GabrielKeys/Projeto_Alarme_FPGA/vivado_fpga/Projeto_Alarme_FPGA/Projeto_Alarme_FPGA.runs/impl_1/.init_design.begin.rst

<?xml version="1.0"?>
<ProcessHandle Version="1" Minor="0">
    <Process Command=".planAhead." Owner="Gabriel" Host="DESKTOP-I9EHUIA" Pid="15572">
    </Process>
</ProcessHandle>
