GabrielKeys/Projeto_Alarme_FPGA/vivado_fpga/Projeto_Alarme_FPGA/Projeto_Alarme_FPGA.runs/impl_1/.vivado.begin.rst

<?xml version="1.0"?>
<ProcessHandle Version="1" Minor="0">
    <Process Command="vivado.bat" Owner="Gabriel" Host="DESKTOP-I9EHUIA" Pid="11236">
    </Process>
</ProcessHandle>
