GabrielKeys/Projeto_Alarme_FPGA/imagens/dashboard_mqtt_inicial.png

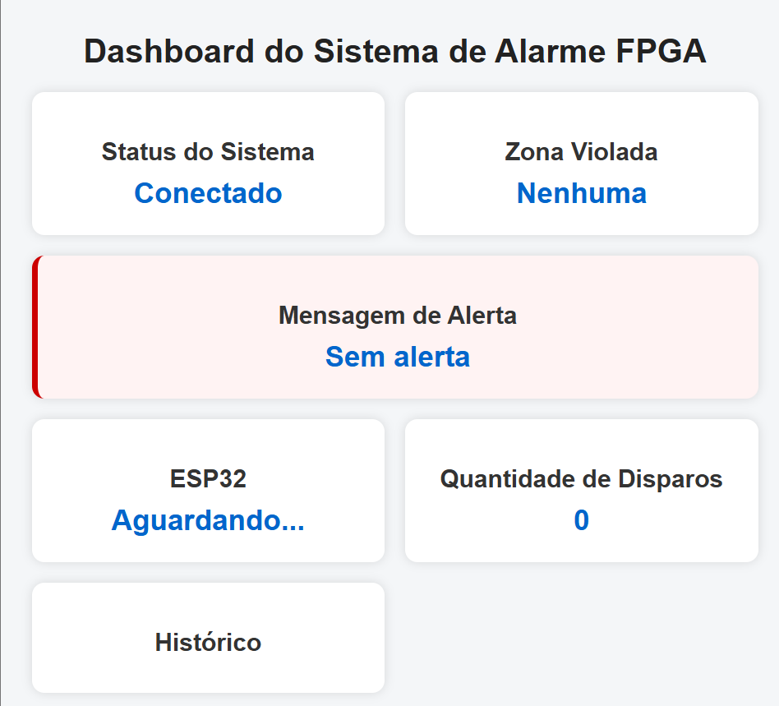
imagens/dashboard_mqtt_inicial.png
