GabrielKeys/Projeto_Alarme_FPGA/imagens/dashboard_mqtt_melhorado.png

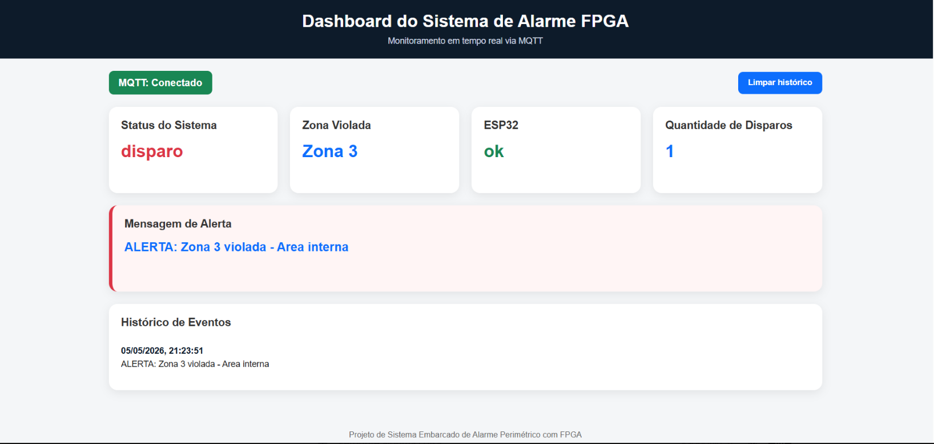
imagens/dashboard_mqtt_melhorado.png
