GabrielKeys/Projeto_Alarme_FPGA/imagens/implementacao_vivado.png

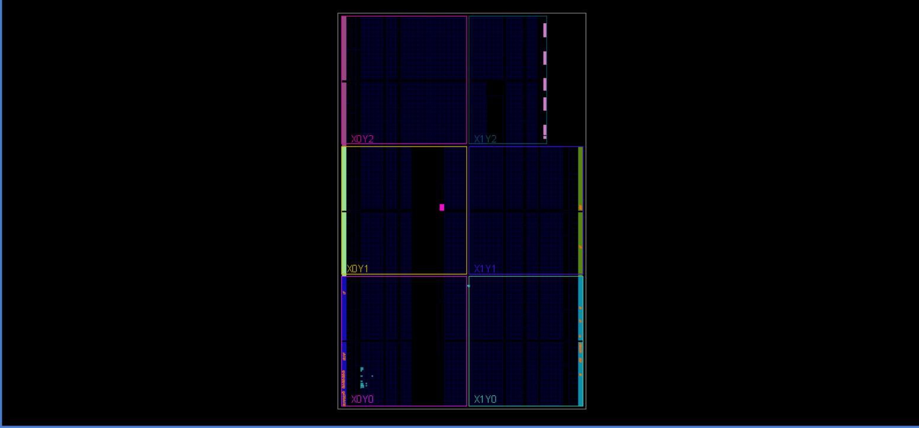
imagens/implementacao_vivado.png
