GabrielKeys/Projeto_Alarme_FPGA/imagens/simulacao_esp_zonas.png

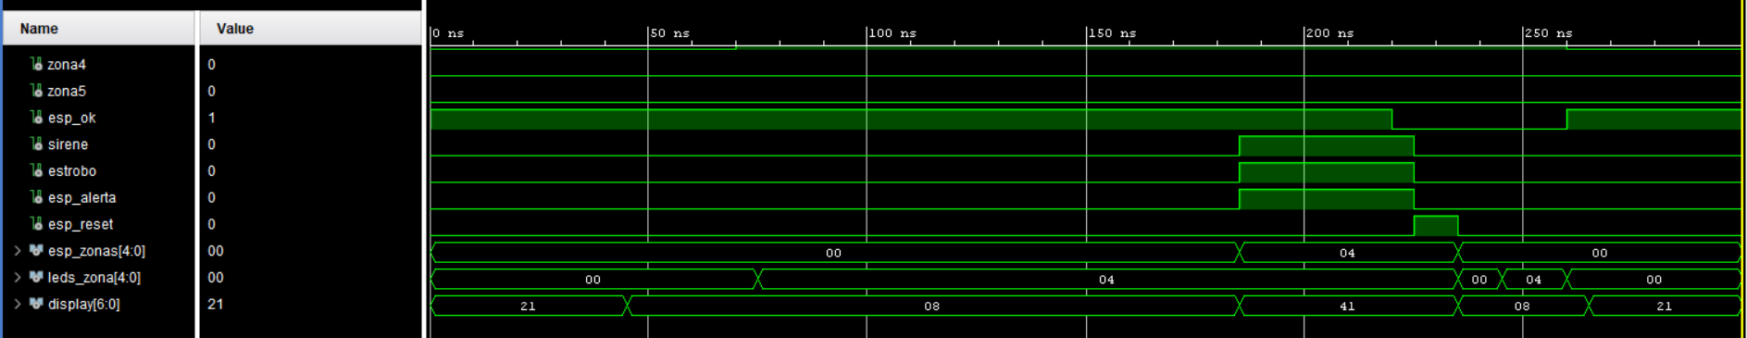
imagens/simulacao_esp_zonas.png
