GabrielKeys/Projeto_Alarme_FPGA/imagens/simulacao_mef_vivado.png

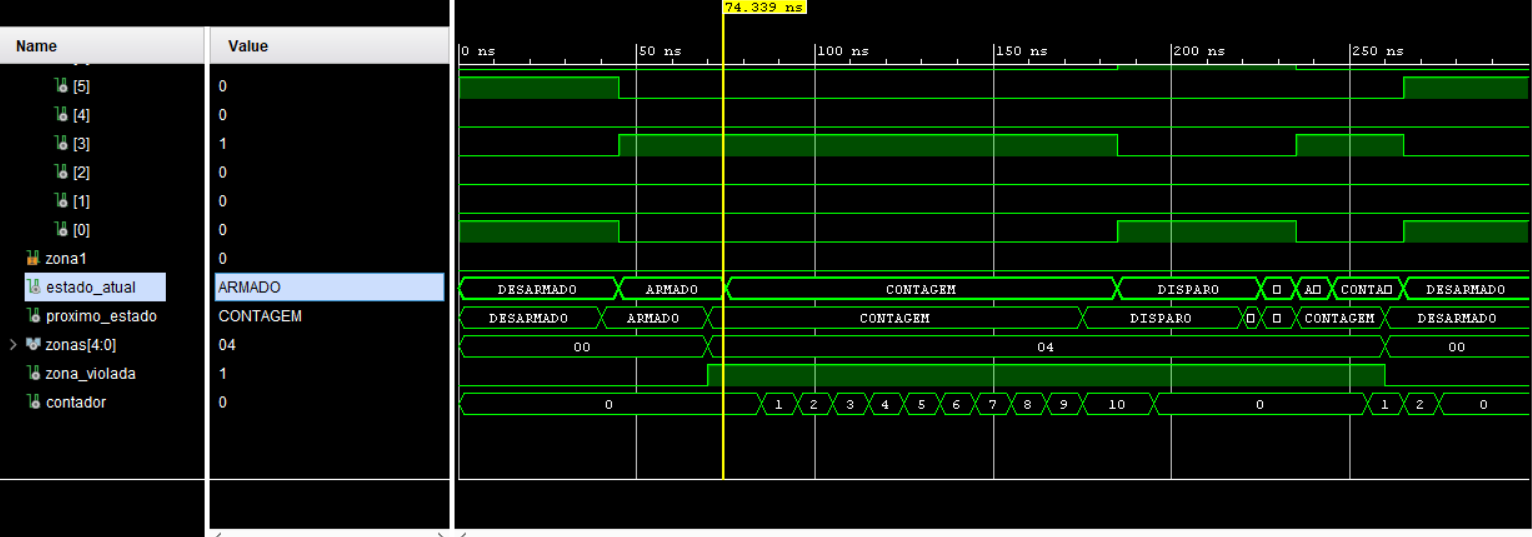
imagens/simulacao_mef_vivado.png
