GabrielKeys/Projeto_Alarme_FPGA/imagens/simulacao_zona_memorizada.png

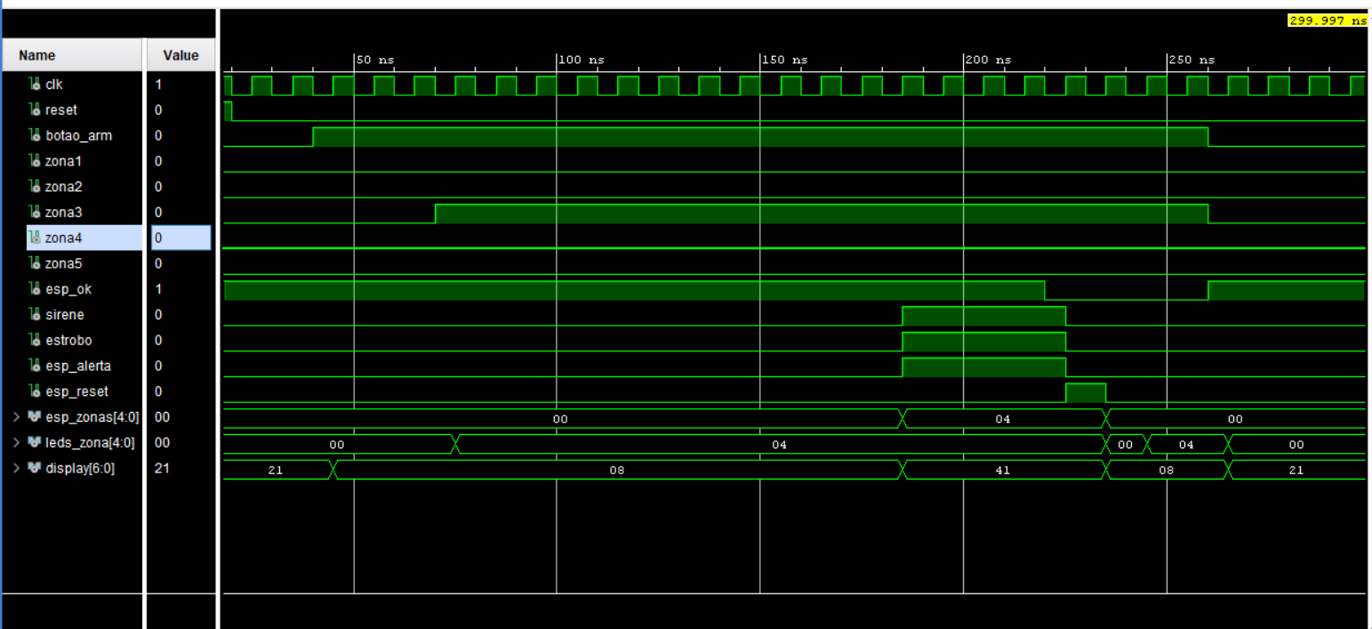
imagens/simulacao_zona_memorizada.png
