GabrielKeys/Projeto_Alarme_FPGA/vivado_fpga/Projeto_Alarme_FPGA/Projeto_Alarme_FPGA.runs/impl_1/usage_statistics_webtalk.html

### Device Usage Page (usage_statistics_webtalk.html)

This HTML page displays the device usage statistics that will be sent to Xilinx.
To see the actual file transmitted to Xilinx, please click here.

software_version_and_target_device
beta | FALSE | build_version | 2258646
date_generated | Mon Jun 15 19:28:20 2026 | os_platform | WIN64
product_version | Vivado v2018.2 (64-bit) | project_id | 2028425938d547d3b7b5718255f06e1f
project_iteration | 11 | random_id | 14f6a7cc-3bba-4563-a50c-01388174601d
registration_id | 14f6a7cc-3bba-4563-a50c-01388174601d | route_design | TRUE
target_device | xc7a35t | target_family | artix7
target_package | cpg236 | target_speed | -1
tool_flow | Vivado

user_environment
cpu_name | Intel(R) Core(TM) i5-9300H CPU @ 2.40GHz | cpu_speed | 2400 MHz
os_name | Microsoft Windows 8 or later , 64-bit | os_release | major release (build 9200)
system_ram | 8.000 GB | total_processors | 1

vivado_usage

gui_handlers
abstractfileview_reload=1 | addsrcwizard_specify_or_create_constraint_files=2 | addsrcwizard_specify_simulation_specific_hdl_files=1 | basedialog_cancel=5
basedialog_ok=28 | basedialog_yes=5 | closeplanner_yes=3 | cmdmsgdialog_ok=9
commandsinput_type_tcl_command_here=7 | constraintschooserpanel_add_files=1 | filesetpanel_file_set_panel_tree=32 | filtertoolbar_show_all=1
flownavigatortreepanel_flow_navigator_tree=65 | fpgachooser_family=1 | fpgachooser_fpga_table=1 | fpgachooser_package=1
fpgachooser_speed=1 | gettingstartedview_create_new_project=1 | graphicalview_zoom_fit=6 | hardwaretreepanel_hardware_tree_table=9
hcodeeditor_search_text_combo_box=2 | launchpanel_generate_scripts_only=1 | logmonitor_monitor=1 | mainmenumgr_file=2
mainmenumgr_run=2 | mainmenumgr_tools=2 | mainmenumgr_view=8 | mainwinmenumgr_layout=20
msgtreepanel_message_view_tree=3 | newprojectwizard_do_not_specify_sources_at_this_time=1 | numjobschooser_number_of_jobs=2 | pacommandnames_auto_connect_target=13
pacommandnames_goto_netlist_design=2 | pacommandnames_reports_window=2 | pacommandnames_run_bitgen=1 | pacommandnames_simulation_run_behavioral=7
paviews_device=1 | paviews_flow_navigator=1 | programdebugtab_available_targets_on_server=1 | programdebugtab_open_target=15
programdebugtab_program_device=8 | programdebugtab_refresh_device=12 | programfpgadialog_program=24 | progressdialog_cancel=2
projectnamechooser_choose_project_location=2 | projectnamechooser_project_name=1 | rdicommands_reset_layout=7 | rdiviews_waveform_viewer=53
simulationobjectspanel_simulation_objects_tree_table=7 | simulationscopespanel_simulate_scope_table=21 | srcchooserpanel_add_hdl_and_netlist_files_to_your_project=2 | tclconsoleview_copy=2
tclconsoleview_tcl_console_code_editor=9 | waveformnametree_waveform_name_tree=4

java_command_handlers
addsources=4 | autoconnecttarget=13 | launchprogramfpga=27 | newhardwaredashboard=1
newproject=1 | openhardwaremanager=24 | openrecenttarget=1 | programdevice=22
refreshdevice=11 | resetlayout=7 | runbitgen=12 | runimplementation=3
runsynthesis=4 | showview=2 | simulationrun=7 | toolssettings=1
viewtaskimplementation=3 | viewtaskprojectmanager=1 | viewtasksynthesis=2

other_data

guimode=12

project_data
constraintsetcount=1 | core_container=false | currentimplrun=impl_1 | currentsynthesisrun=synth_1
default_library=xil_defaultlib | designmode=RTL | export_simulation_activehdl=0 | export_simulation_ies=0
export_simulation_modelsim=0 | export_simulation_questa=0 | export_simulation_riviera=0 | export_simulation_vcs=0
export_simulation_xsim=0 | implstrategy=Vivado Implementation Defaults | launch_simulation_activehdl=0 | launch_simulation_ies=0
launch_simulation_modelsim=0 | launch_simulation_questa=0 | launch_simulation_riviera=0 | launch_simulation_vcs=0
launch_simulation_xsim=5 | simulator_language=Mixed | srcsetcount=1 | synthesisstrategy=Vivado Synthesis Defaults
target_language=Verilog | target_simulator=XSim | totalimplruns=1 | totalsynthesisruns=1

unisim_transformation

post_unisim_transformation
bufg=1 | carry4=7 | fdce=38 | gnd=1
ibuf=9 | lut2=12 | lut3=3 | lut4=14
lut5=4 | lut6=37 | obuf=21 | vcc=1

pre_unisim_transformation
bufg=1 | carry4=7 | fdce=38 | gnd=1
ibuf=9 | lut2=12 | lut3=3 | lut4=14
lut5=4 | lut6=37 | obuf=21 | vcc=1

report_drc

command_line_options
-append=default::[not_specified] | -checks=default::[not_specified] | -fail_on=default::[not_specified] | -force=default::[not_specified]
-format=default::[not_specified] | -internal=default::[not_specified] | -internal_only=default::[not_specified] | -messages=default::[not_specified]
-name=default::[not_specified] | -no_waivers=default::[not_specified] | -return_string=default::[not_specified] | -ruledecks=default::[not_specified]
-upgrade_cw=default::[not_specified] | -waived=default::[not_specified]

report_methodology

command_line_options
-append=default::[not_specified] | -checks=default::[not_specified] | -fail_on=default::[not_specified] | -force=default::[not_specified]
-format=default::[not_specified] | -messages=default::[not_specified] | -name=default::[not_specified] | -return_string=default::[not_specified]

-waived=default::[not_specified]

results

timing-18=29

report_power

command_line_options
-advisory=default::[not_specified] | -append=default::[not_specified] | -file=[specified] | -format=default::text
-hier=default::power | -l=default::[not_specified] | -name=default::[not_specified] | -no_propagation=default::[not_specified]
-return_string=default::[not_specified] | -rpx=[specified] | -verbose=default::[not_specified] | -vid=default::[not_specified]

-xpe=default::[not_specified]

usage
airflow=250 (LFM) | ambient_temp=25.0 (C) | bi-dir_toggle=12.500000 | bidir_output_enable=1.000000
board_layers=12to15 (12 to 15 Layers) | board_selection=medium (10"x10") | clocks=0.001000 | confidence_level_clock_activity=High
confidence_level_design_state=High | confidence_level_device_models=High | confidence_level_internal_activity=Medium | confidence_level_io_activity=Low
confidence_level_overall=Low | customer=TBD | customer_class=TBD | devstatic=0.071719
die=xc7a35tcpg236-1 | dsp_output_toggle=12.500000 | dynamic=0.008717 | effective_thetaja=5.0
enable_probability=0.990000 | family=artix7 | ff_toggle=12.500000 | flow_state=routed
heatsink=medium (Medium Profile) | i/o=0.007328 | input_toggle=12.500000 | junction_temp=25.4 (C)
logic=0.000143 | mgtavcc_dynamic_current=0.000000 | mgtavcc_static_current=0.000000 | mgtavcc_total_current=0.000000
mgtavcc_voltage=1.000000 | mgtavtt_dynamic_current=0.000000 | mgtavtt_static_current=0.000000 | mgtavtt_total_current=0.000000
mgtavtt_voltage=1.200000 | netlist_net_matched=NA | off-chip_power=0.000000 | on-chip_power=0.080436
output_enable=1.000000 | output_load=5.000000 | output_toggle=12.500000 | package=cpg236
pct_clock_constrained=1.000000 | pct_inputs_defined=11 | platform=nt64 | process=typical
ram_enable=50.000000 | ram_write=50.000000 | read_saif=False | set/reset_probability=0.000000
signal_rate=False | signals=0.000245 | simulation_file=None | speedgrade=-1
static_prob=False | temp_grade=commercial | thetajb=7.5 (C/W) | thetasa=4.6 (C/W)
toggle_rate=False | user_board_temp=25.0 (C) | user_effective_thetaja=5.0 | user_junc_temp=25.4 (C)
user_thetajb=7.5 (C/W) | user_thetasa=4.6 (C/W) | vccadc_dynamic_current=0.000000 | vccadc_static_current=0.020000
vccadc_total_current=0.020000 | vccadc_voltage=1.800000 | vccaux_dynamic_current=0.000265 | vccaux_io_dynamic_current=0.000000
vccaux_io_static_current=0.000000 | vccaux_io_total_current=0.000000 | vccaux_io_voltage=1.800000 | vccaux_static_current=0.012616
vccaux_total_current=0.012881 | vccaux_voltage=1.800000 | vccbram_dynamic_current=0.000000 | vccbram_static_current=0.000162
vccbram_total_current=0.000162 | vccbram_voltage=1.000000 | vccint_dynamic_current=0.001481 | vccint_static_current=0.009549
vccint_total_current=0.011030 | vccint_voltage=1.000000 | vcco12_dynamic_current=0.000000 | vcco12_static_current=0.000000
vcco12_total_current=0.000000 | vcco12_voltage=1.200000 | vcco135_dynamic_current=0.000000 | vcco135_static_current=0.000000
vcco135_total_current=0.000000 | vcco135_voltage=1.350000 | vcco15_dynamic_current=0.000000 | vcco15_static_current=0.000000
vcco15_total_current=0.000000 | vcco15_voltage=1.500000 | vcco18_dynamic_current=0.000000 | vcco18_static_current=0.000000
vcco18_total_current=0.000000 | vcco18_voltage=1.800000 | vcco25_dynamic_current=0.000000 | vcco25_static_current=0.000000
vcco25_total_current=0.000000 | vcco25_voltage=2.500000 | vcco33_dynamic_current=0.002048 | vcco33_static_current=0.001000
vcco33_total_current=0.003048 | vcco33_voltage=3.300000 | version=2018.2

report_utilization

clocking
bufgctrl_available=32 | bufgctrl_fixed=0 | bufgctrl_used=1 | bufgctrl_util_percentage=3.13
bufhce_available=72 | bufhce_fixed=0 | bufhce_used=0 | bufhce_util_percentage=0.00
bufio_available=20 | bufio_fixed=0 | bufio_used=0 | bufio_util_percentage=0.00
bufmrce_available=10 | bufmrce_fixed=0 | bufmrce_used=0 | bufmrce_util_percentage=0.00
bufr_available=20 | bufr_fixed=0 | bufr_used=0 | bufr_util_percentage=0.00
mmcme2_adv_available=5 | mmcme2_adv_fixed=0 | mmcme2_adv_used=0 | mmcme2_adv_util_percentage=0.00
plle2_adv_available=5 | plle2_adv_fixed=0 | plle2_adv_used=0 | plle2_adv_util_percentage=0.00

dsp
dsps_available=90 | dsps_fixed=0 | dsps_used=0 | dsps_util_percentage=0.00

io_standard
blvds_25=0 | diff_hstl_i=0 | diff_hstl_i_18=0 | diff_hstl_ii=0
diff_hstl_ii_18=0 | diff_hsul_12=0 | diff_mobile_ddr=0 | diff_sstl135=0
diff_sstl135_r=0 | diff_sstl15=0 | diff_sstl15_r=0 | diff_sstl18_i=0
diff_sstl18_ii=0 | hstl_i=0 | hstl_i_18=0 | hstl_ii=0
hstl_ii_18=0 | hsul_12=0 | lvcmos12=0 | lvcmos15=0
lvcmos18=0 | lvcmos25=0 | lvcmos33=1 | lvds_25=0
lvttl=0 | mini_lvds_25=0 | mobile_ddr=0 | pci33_3=0
ppds_25=0 | rsds_25=0 | sstl135=0 | sstl135_r=0
sstl15=0 | sstl15_r=0 | sstl18_i=0 | sstl18_ii=0

tmds_33=0

memory
block_ram_tile_available=50 | block_ram_tile_fixed=0 | block_ram_tile_used=0 | block_ram_tile_util_percentage=0.00
ramb18_available=100 | ramb18_fixed=0 | ramb18_used=0 | ramb18_util_percentage=0.00
ramb36_fifo_available=50 | ramb36_fifo_fixed=0 | ramb36_fifo_used=0 | ramb36_fifo_util_percentage=0.00

primitives
bufg_functional_category=Clock | bufg_used=1 | carry4_functional_category=CarryLogic | carry4_used=7
fdce_functional_category=Flop & Latch | fdce_used=38 | ibuf_functional_category=IO | ibuf_used=9
lut2_functional_category=LUT | lut2_used=12 | lut3_functional_category=LUT | lut3_used=3
lut4_functional_category=LUT | lut4_used=14 | lut5_functional_category=LUT | lut5_used=5
lut6_functional_category=LUT | lut6_used=36 | obuf_functional_category=IO | obuf_used=21

slice_logic
f7_muxes_available=16300 | f7_muxes_fixed=0 | f7_muxes_used=0 | f7_muxes_util_percentage=0.00
f8_muxes_available=8150 | f8_muxes_fixed=0 | f8_muxes_used=0 | f8_muxes_util_percentage=0.00
lut_as_logic_available=20800 | lut_as_logic_fixed=0 | lut_as_logic_used=68 | lut_as_logic_util_percentage=0.33
lut_as_memory_available=9600 | lut_as_memory_fixed=0 | lut_as_memory_used=0 | lut_as_memory_util_percentage=0.00
register_as_flip_flop_available=41600 | register_as_flip_flop_fixed=0 | register_as_flip_flop_used=38 | register_as_flip_flop_util_percentage=0.09
register_as_latch_available=41600 | register_as_latch_fixed=0 | register_as_latch_used=0 | register_as_latch_util_percentage=0.00
slice_luts_available=20800 | slice_luts_fixed=0 | slice_luts_used=68 | slice_luts_util_percentage=0.33
slice_registers_available=41600 | slice_registers_fixed=0 | slice_registers_used=38 | slice_registers_util_percentage=0.09
fully_used_lut_ff_pairs_fixed=0.09 | fully_used_lut_ff_pairs_used=0 | lut_as_distributed_ram_fixed=0 | lut_as_distributed_ram_used=0
lut_as_logic_available=20800 | lut_as_logic_fixed=0 | lut_as_logic_used=68 | lut_as_logic_util_percentage=0.33
lut_as_memory_available=9600 | lut_as_memory_fixed=0 | lut_as_memory_used=0 | lut_as_memory_util_percentage=0.00
lut_as_shift_register_fixed=0 | lut_as_shift_register_used=0 | lut_ff_pairs_with_one_unused_flip_flop_fixed=0 | lut_ff_pairs_with_one_unused_flip_flop_used=38
lut_ff_pairs_with_one_unused_lut_output_fixed=38 | lut_ff_pairs_with_one_unused_lut_output_used=37 | lut_flip_flop_pairs_available=20800 | lut_flip_flop_pairs_fixed=0
lut_flip_flop_pairs_used=38 | lut_flip_flop_pairs_util_percentage=0.18 | slice_available=8150 | slice_fixed=0
slice_used=32 | slice_util_percentage=0.39 | slicel_fixed=0 | slicel_used=20
slicem_fixed=0 | slicem_used=12 | unique_control_sets_used=3 | using_o5_and_o6_fixed=3
using_o5_and_o6_used=2 | using_o5_output_only_fixed=2 | using_o5_output_only_used=0 | using_o6_output_only_fixed=0

using_o6_output_only_used=66

specific_feature
bscane2_available=4 | bscane2_fixed=0 | bscane2_used=0 | bscane2_util_percentage=0.00
capturee2_available=1 | capturee2_fixed=0 | capturee2_used=0 | capturee2_util_percentage=0.00
dna_port_available=1 | dna_port_fixed=0 | dna_port_used=0 | dna_port_util_percentage=0.00
efuse_usr_available=1 | efuse_usr_fixed=0 | efuse_usr_used=0 | efuse_usr_util_percentage=0.00
frame_ecce2_available=1 | frame_ecce2_fixed=0 | frame_ecce2_used=0 | frame_ecce2_util_percentage=0.00
icape2_available=2 | icape2_fixed=0 | icape2_used=0 | icape2_util_percentage=0.00
pcie_2_1_available=1 | pcie_2_1_fixed=0 | pcie_2_1_used=0 | pcie_2_1_util_percentage=0.00
startupe2_available=1 | startupe2_fixed=0 | startupe2_used=0 | startupe2_util_percentage=0.00
xadc_available=1 | xadc_fixed=0 | xadc_used=0 | xadc_util_percentage=0.00

router

usage
actual_expansions=148984 | bogomips=0 | bram18=0 | bram36=0
bufg=0 | bufr=0 | congestion_level=0 | ctrls=3
dsp=0 | effort=2 | estimated_expansions=226950 | ff=38
global_clocks=1 | high_fanout_nets=0 | iob=30 | lut=70
movable_instances=148 | nets=182 | pins=780 | pll=0
router_runtime=0.000000 | router_timing_driven=1 | threads=2 | timing_constraints_exist=1

synthesis

command_line_options
-assert=default::[not_specified] | -bufg=default::12 | -cascade_dsp=default::auto | -constrset=default::[not_specified]
-control_set_opt_threshold=default::auto | -directive=default::default | -fanout_limit=default::10000 | -flatten_hierarchy=default::rebuilt
-fsm_extraction=default::auto | -gated_clock_conversion=default::off | -generic=default::[not_specified] | -include_dirs=default::[not_specified]
-keep_equivalent_registers=default::[not_specified] | -max_bram=default::-1 | -max_bram_cascade_height=default::-1 | -max_dsp=default::-1
-max_uram=default::-1 | -max_uram_cascade_height=default::-1 | -mode=default::default | -name=default::[not_specified]
-no_lc=default::[not_specified] | -no_srlextract=default::[not_specified] | -no_timing_driven=default::[not_specified] | -part=xc7a35tcpg236-1
-resource_sharing=default::auto | -retiming=default::[not_specified] | -rtl=default::[not_specified] | -rtl_skip_constraints=default::[not_specified]
-rtl_skip_ip=default::[not_specified] | -seu_protect=default::none | -sfcu=default::[not_specified] | -shreg_min_size=default::3
-top=alarme_top | -verilog_define=default::[not_specified]

usage
elapsed=00:00:27s | hls_ip=0 | memory_gain=508.578MB | memory_peak=810.426MB

xsim

command_line_options
-sim_mode=default::behavioral | -sim_type=default::
