GabrielKeys/Projeto_Alarme_FPGA/imagens/dashboard_mqtt_teste.png

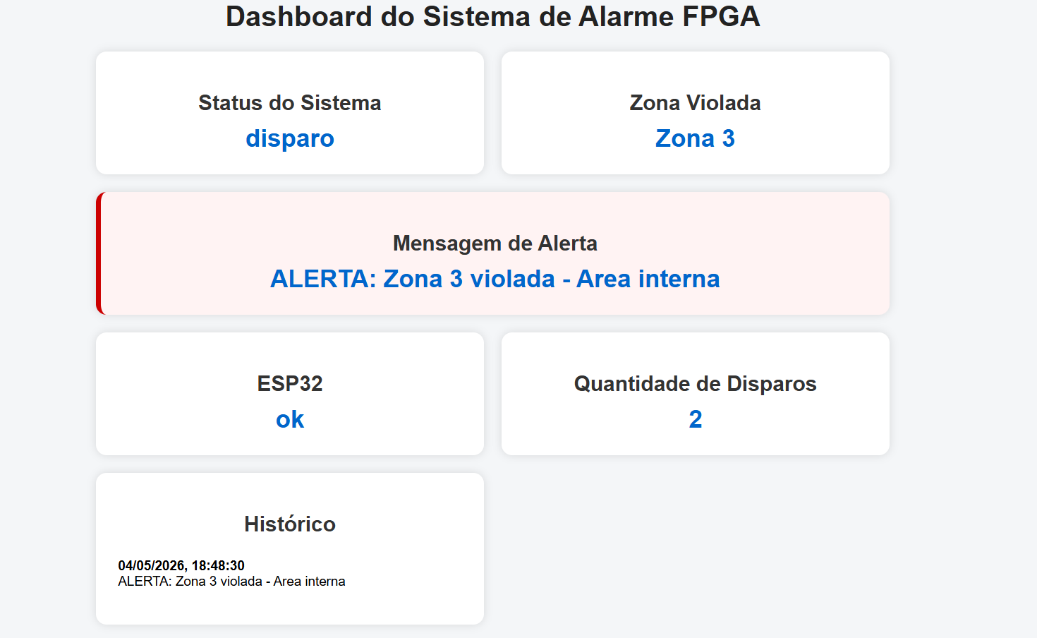
imagens/dashboard_mqtt_teste.png
