GabrielKeys/Projeto_Alarme_FPGA/vivado_fpga/Projeto_Alarme_FPGA/Projeto_Alarme_FPGA.runs/synth_1/.Xil/alarme_top_propImpl.xdc

set_property SRC_FILE_INFO {cfile:C:/Users/Gabriel/OneDrive/Documentos/Atividades/Projeto_Alarme_FPGA/vivado_fpga/constraints/alarme_basys3.xdc rfile:../../../../constraints/alarme_basys3.xdc id:1} [current_design]
set_property src_info {type:XDC file:1 line:2 export:INPUT save:INPUT read:READ} [current_design]
set_property PACKAGE_PIN W5 [get_ports clk]
set_property src_info {type:XDC file:1 line:7 export:INPUT save:INPUT read:READ} [current_design]
set_property PACKAGE_PIN U18 [get_ports reset]
set_property src_info {type:XDC file:1 line:11 export:INPUT save:INPUT read:READ} [current_design]
set_property PACKAGE_PIN V17 [get_ports botao_arm]
set_property src_info {type:XDC file:1 line:14 export:INPUT save:INPUT read:READ} [current_design]
set_property PACKAGE_PIN V16 [get_ports zona1]
set_property src_info {type:XDC file:1 line:17 export:INPUT save:INPUT read:READ} [current_design]
set_property PACKAGE_PIN W16 [get_ports zona2]
set_property src_info {type:XDC file:1 line:20 export:INPUT save:INPUT read:READ} [current_design]
set_property PACKAGE_PIN W17 [get_ports zona3]
set_property src_info {type:XDC file:1 line:23 export:INPUT save:INPUT read:READ} [current_design]
set_property PACKAGE_PIN W15 [get_ports zona4]
set_property src_info {type:XDC file:1 line:26 export:INPUT save:INPUT read:READ} [current_design]
set_property PACKAGE_PIN V15 [get_ports zona5]
set_property src_info {type:XDC file:1 line:30 export:INPUT save:INPUT read:READ} [current_design]
set_property PACKAGE_PIN G3 [get_ports esp_ok]
set_property src_info {type:XDC file:1 line:34 export:INPUT save:INPUT read:READ} [current_design]
set_property PACKAGE_PIN U15 [get_ports sirene]
set_property src_info {type:XDC file:1 line:37 export:INPUT save:INPUT read:READ} [current_design]
set_property PACKAGE_PIN U14 [get_ports estrobo]
set_property src_info {type:XDC file:1 line:41 export:INPUT save:INPUT read:READ} [current_design]
set_property PACKAGE_PIN J1 [get_ports esp_alerta]
set_property src_info {type:XDC file:1 line:44 export:INPUT save:INPUT read:READ} [current_design]
set_property PACKAGE_PIN V13 [get_ports esp_reset]
set_property src_info {type:XDC file:1 line:48 export:INPUT save:INPUT read:READ} [current_design]
set_property PACKAGE_PIN U16 [get_ports {leds_zona[0]}]
set_property src_info {type:XDC file:1 line:51 export:INPUT save:INPUT read:READ} [current_design]
set_property PACKAGE_PIN E19 [get_ports {leds_zona[1]}]
set_property src_info {type:XDC file:1 line:54 export:INPUT save:INPUT read:READ} [current_design]
set_property PACKAGE_PIN U19 [get_ports {leds_zona[2]}]
set_property src_info {type:XDC file:1 line:57 export:INPUT save:INPUT read:READ} [current_design]
set_property PACKAGE_PIN V19 [get_ports {leds_zona[3]}]
set_property src_info {type:XDC file:1 line:60 export:INPUT save:INPUT read:READ} [current_design]
set_property PACKAGE_PIN W18 [get_ports {leds_zona[4]}]
set_property src_info {type:XDC file:1 line:66 export:INPUT save:INPUT read:READ} [current_design]
set_property PACKAGE_PIN A14 [get_ports {esp_zonas[0]}]
set_property src_info {type:XDC file:1 line:70 export:INPUT save:INPUT read:READ} [current_design]
set_property PACKAGE_PIN A16 [get_ports {esp_zonas[1]}]
set_property src_info {type:XDC file:1 line:74 export:INPUT save:INPUT read:READ} [current_design]
set_property PACKAGE_PIN B15 [get_ports {esp_zonas[2]}]
set_property src_info {type:XDC file:1 line:78 export:INPUT save:INPUT read:READ} [current_design]
set_property PACKAGE_PIN B16 [get_ports {esp_zonas[3]}]
set_property src_info {type:XDC file:1 line:82 export:INPUT save:INPUT read:READ} [current_design]
set_property PACKAGE_PIN A15 [get_ports {esp_zonas[4]}]
set_property src_info {type:XDC file:1 line:85 export:INPUT save:INPUT read:READ} [current_design]
set_property PACKAGE_PIN W7 [get_ports {display[0]}]
set_property src_info {type:XDC file:1 line:88 export:INPUT save:INPUT read:READ} [current_design]
set_property PACKAGE_PIN W6 [get_ports {display[1]}]
set_property src_info {type:XDC file:1 line:91 export:INPUT save:INPUT read:READ} [current_design]
set_property PACKAGE_PIN U8 [get_ports {display[2]}]
set_property src_info {type:XDC file:1 line:94 export:INPUT save:INPUT read:READ} [current_design]
set_property PACKAGE_PIN V8 [get_ports {display[3]}]
set_property src_info {type:XDC file:1 line:97 export:INPUT save:INPUT read:READ} [current_design]
set_property PACKAGE_PIN U5 [get_ports {display[4]}]
set_property src_info {type:XDC file:1 line:100 export:INPUT save:INPUT read:READ} [current_design]
set_property PACKAGE_PIN V5 [get_ports {display[5]}]
set_property src_info {type:XDC file:1 line:103 export:INPUT save:INPUT read:READ} [current_design]
set_property PACKAGE_PIN U7 [get_ports {display[6]}]
