GabrielKeys/Projeto_Alarme_FPGA/(commit log)

2026-05-06 Versao limpa do projeto de alarme FPGA
2026-05-06 Finalização para testes fisicos
2026-06-13 Teste no esp32 concluido
2026-06-19 Definição de Contagem do alarme
